Auktoriator/RaspberryPi_Projekte/PiCRAFT_NAS.FCStd

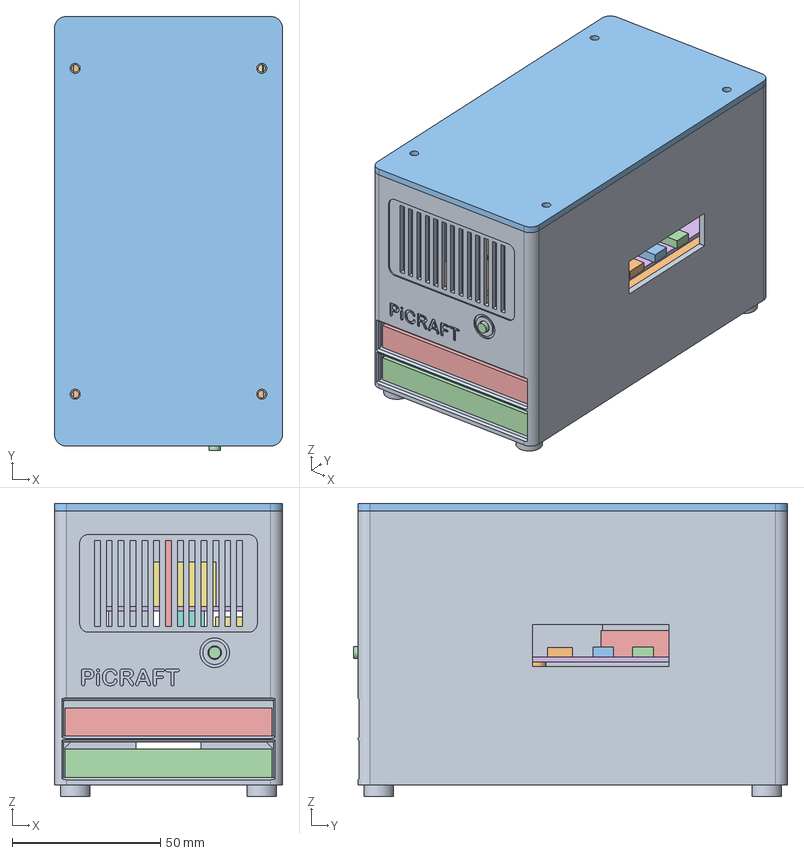
[picture p4: CAD file, 2026-10-27]
PiCRAFT_NAS.FCStd
77.0 x 146.5 x 99.0 mm
Gehaeuse
Pi_Traeger
Deckel
Power_Stoessel
Filterrahmen
Pi5_Platine
Pi5_Ethernet
Pi5_USB_1
Pi5_USB_2
Pi5_USB_C
Pi5_HDMI_0
Pi5_HDMI_1
Pi5_Aktivkuehler
M2_HAT
M2_SSD_mit_Kuehler
Pi5_Powerknopf
Luefter_40mm
Adapter_1
Adapter_2
HDD_1
HDD_2
