Auktoriator/RaspberryPi_Projekte/stl/PiCRAFT_Server/Deckel.stl

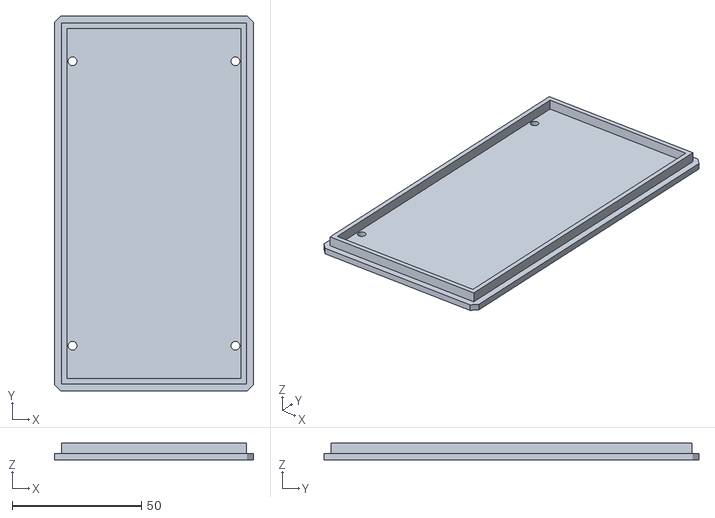
[picture p5: CAD file, 2026-10-27]
stl/PiCRAFT_Server/Deckel.stl
77.0 x 145.0 x 6.50
