Auktoriator/RaspberryPi_Projekte/stl/PiCRAFT_Server/Power_Stoessel.stl

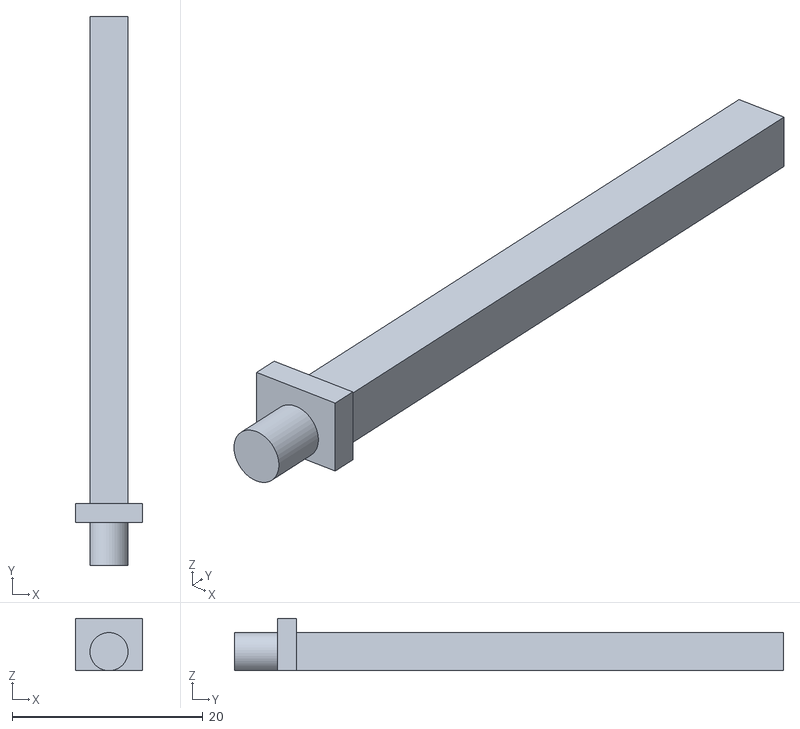
[picture p7: CAD file, 2026-10-27]
stl/PiCRAFT_Server/Power_Stoessel.stl
7.00 x 57.5 x 5.50
