Auktoriator/RaspberryPi_Projekte/stl/PiCRAFT_Server/Filterrahmen.stl

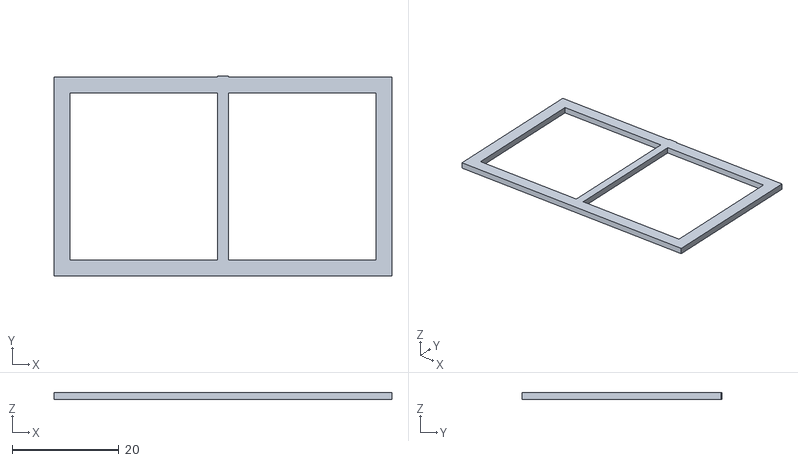
[picture p8: CAD file, 2026-10-27]
stl/PiCRAFT_Server/Filterrahmen.stl
63.4 x 37.5 x 1.40
