Auktoriator/RaspberryPi_Projekte/stl/PiCRAFT_Server/Pi_Traeger.stl

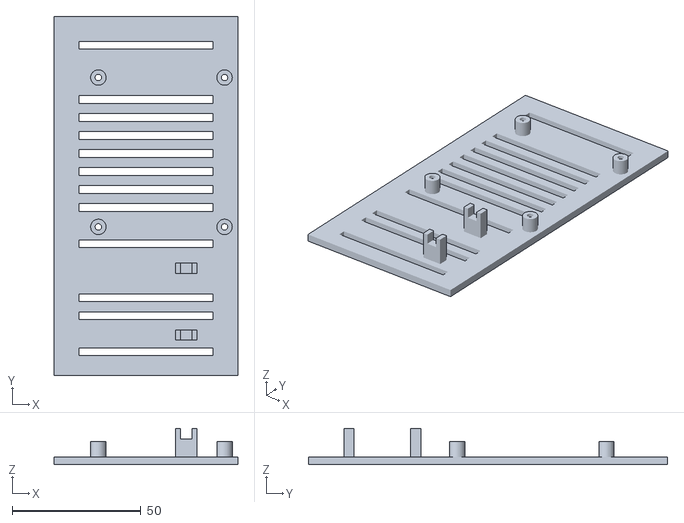
[picture p9: CAD file, 2026-10-27]
stl/PiCRAFT_Server/Pi_Traeger.stl
71.4 x 139.4 x 14.1
