Auktoriator/RaspberryPi_Projekte/stl/PiCRAFT_Server/Gehaeuse.stl

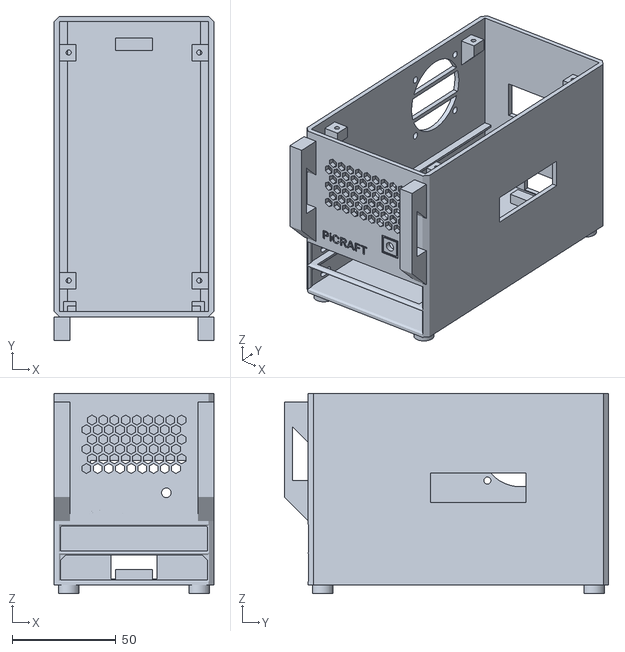
[picture p10: CAD file, 2026-10-27]
stl/PiCRAFT_Server/Gehaeuse.stl
77.0 x 156.5 x 96.5
