Auktoriator/RaspberryPi_Projekte/(list of files, cad)

Other CAD files:
PiCRAFT_Server.blend
