Auktoriator/RaspberryPi_Projekte/(commit log)

2026-10-27 Pi 5 Mini-NAS-Gehäuse, Version 2
    Bauskript für FreeCAD (Wanne, Pi-Träger, geschlossener Deckel,
    40-mm-Abluftlüfter), README mit aktuellem Stand und CLAUDE.md.
    [Pi5_NAS_Gehaeuse.FCStd]
2026-10-27 Version 3: gemessene HAT-Höhen, mehr Tiefe für USB-SATA-Adapter
    HAT-Abstand 15,5 mm, SSD-Aufbau 15 mm, Innentiefe 128 -> 140 mm
    (Laufwerk + Adapter 120 mm plus 20 mm Kabelbogen).
    [Pi5_NAS_Gehaeuse.FCStd]
2026-10-27 README: PCIe-Varianten für M.2 HAT+ und AI HAT+ 2, SSD-Kabel, Aufgabenliste
    Produktbeschreibung des AI HAT+ 2 hinzugefügt.
2026-10-27 Version 4: Laufwerke und Deckel verschraubt, Power-Stößel, Zugentlastung, Staubfilter
    - Langlöcher in der linken Wand für M3-Schrauben in die Laufwerks-Seitenlöcher
    - Vier Schraubdome für den Deckel
    - Power-Stößel in U-Führungen auf dem Pi-Träger
    - Kabeldurchlass mit Kabelbinder-Brücke statt großer Rücköffnung
    - Filterrahmen hinter den Front-Schlitzen, übrige Lüftungsschlitze geschlossen
    - AI-HAT-Reserve aus den Referenzteilen entfernt, Höhe unverändert
    - README: Lüftersteuerung mit gpio-fan, Schraubenliste, Aufgabenliste
    [Pi5_NAS_Gehaeuse.FCStd]
2026-10-27 Version 5: Front im NAS-Look, abgerundete Außenkanten
    Angefaste Schachtöffnungen, Lüftungsgitter im vertieften Feld,
    runder Power-Druckpunkt mit Ring, Schriftzug PiNAS, Schachtnummern
    auf der linken Wand, runde Füße, gerenderte Ansicht in der README.
    [Pi5_NAS_Gehaeuse.FCStd]
2026-10-27 Version 6: zweite Stil-Variante „server“
    Wabengitter, Rack-Griffe, gefaste Kanten, quadratischer Power-Rahmen.
    Das Skript baut beide Stile mit gleichem Innenleben in eigene Dokumente.
    [Pi5_NAS_Gehaeuse.FCStd, Pi5_NAS_Gehaeuse_Server.FCStd]
2026-10-27 Version 7: Name PiCRAFT
    Schriftzug PiCRAFT auf beiden Stilen, Skript und FreeCAD-Dateien
    umbenannt, Server als Hauptstil in README und Skript.
    [Pi5_NAS_Gehaeuse.FCStd, Pi5_NAS_Gehaeuse_Server.FCStd, PiCRAFT_NAS.FCStd, PiCRAFT_Server.FCStd]
2026-10-27 Version 8: STL-Export für den Server-Stil, Außenmaße in der README
    - Druckteile werden in Druckausrichtung nach stl/PiCRAFT_Server/ exportiert
    und auf geschlossene, überschneidungsfreie Netze geprüft
    - Stößel-Bund unten bündig, damit er flach gedruckt werden kann
    - Lüftungsschlitze im Pi-Träger stoßen nicht mehr an die Stößel-Führungen
    [Deckel.stl, Filterrahmen.stl, Gehaeuse.stl, PiCRAFT_NAS.FCStd, PiCRAFT_Server.FCStd, Pi_Traeger.stl, Power_Stoessel.stl]
2026-10-27 Blender-Szene des Server-Stils
    PiCRAFT_Server.blend: die fünf STL-Druckteile in Einbaulage zusammengesetzt.
    README und CLAUDE.md beschreiben die Datei und wie sie aktualisiert wird;
    Blender-Sicherungen (*.blend1) werden ignoriert.
    [PiCRAFT_Server.blend]
2026-10-27 FreeCAD-Modelle nach dem STL-Export neu gespeichert
    [PiCRAFT_NAS.FCStd, PiCRAFT_Server.FCStd]
2026-11-01 PDF des AI HAT+ 2 durch Link auf die Herstellerseite ersetzen
